Ma-Pe-Ma/Shutter-Controller/(list of files, drawings)

Other design files:
Controlling Circuit/ShutterController/PCB_ShutterController.json
