Ma-Pe-Ma/Shutter-Controller/Wasm-client/src/sc/RequestQueue.h

#ifndef REQUESTQUEUE_H
#define REQUESTQUEUE_H

#include <queue>
#include <memory>
#include <mutex>
#include <atomic>

#include "request/Request.h"

class RequestQueue {
	std::queue<std::shared_ptr<Request>> requestQueue;
	std::shared_ptr<Request> currentRequest = nullptr;
	std::mutex requestMutex;

	std::string siteAddress = "";
	std::string parameters = "";

	bool lastRequestSuccess = true;
public:
	void setSiteAddress(std::string siteAddress, std::string parameters) {
		this->siteAddress = siteAddress;
		this->parameters = parameters;
	}

	void pushNewRequest(std::shared_ptr<Request> newRequest);
	void pushNewRequestIfQueueIsEmpty(std::shared_ptr<Request> newRequest);	

	bool isActive();
	bool getLastRequestSuccess() { return lastRequestSuccess; }	

	void tryDequeue();
	void terminate();
};

#endif // !REQUESTQUEUE_H
