Ma-Pe-Ma/Shutter-Controller/ESP8266_Server/src/app/Processes/ZeroProcess.cpp

#include "ZeroProcess.h"
#include "../TimeCalibration.h"

void ZeroProcess::start(const float currentValue) {
    processStartTime = millis();
    digitalWrite(UP_PIN, DEACTIVATE_PIN);
    digitalWrite(DOWN_PIN, DEACTIVATE_PIN);

    zeroFound = false;
    targetValue = currentValue;

    if (targetValue < 0.5f) {
        processTime = 1.0f / downSpeed;
        digitalWrite(DOWN_PIN, ACTIVATE_PIN);
    }
    else {
        processTime = 1.0f / upSpeed;
        digitalWrite(UP_PIN, ACTIVATE_PIN);
    }

    processTime += 3.0f;

    Serial.println("Zero process started, process time: " + String(processTime));
}
    
bool ZeroProcess::checkFinished() {
    if (!zeroFound) {
        if (millis() - processStartTime > processTime * 1000) {   
            if (targetValue < 0.5f) {
                digitalWrite(DOWN_PIN, DEACTIVATE_PIN);
                digitalWrite(UP_PIN, ACTIVATE_PIN);
                processTime = targetValue / upSpeed;
            }
            else {
                digitalWrite(UP_PIN, DEACTIVATE_PIN);
                digitalWrite(DOWN_PIN, ACTIVATE_PIN);                
                processTime = (1.0f - targetValue) / downSpeed;
            }

            zeroFound = true;
            processStartTime = millis(); 

            Serial.println("Zeroing half, new processs time: " + String(processTime));
        }
    }
    else {
        if (millis() - processStartTime > processTime * 1000) {
            digitalWrite(UP_PIN, DEACTIVATE_PIN);
            digitalWrite(DOWN_PIN, DEACTIVATE_PIN);
            
            Serial.println("Zeroing finished: " + String(targetValue));
            return true;
        }
    }

    return false;
}

std::tuple<Shutter_Event, int> ZeroProcess::generateMessage() {
    return {Shutter_Event_zero_find, (int) (targetValue * 100)};
}
