Ma-Pe-Ma/Shutter-Controller/ESP8266_Server/src/app/MessageHandler.cpp

#include "MessageHandler.h"
#include "TimeCalibration.h"

#include "pb_decode.h"
#include "pb_encode.h"

void MessageHandler::initialize() {
    loadMessagesFromFlash();
    //TODO: add proper value for start
    addNewMessage(Shutter_Event_start, 0);
}

void MessageHandler::addNewMessage(Shutter_Event event, int value) {
    for (int i = 0; i < NR_OF_MESSAGES - 1; i++) {
        messageContainer.genericMessage[NR_OF_MESSAGES - 1 - i] = messageContainer.genericMessage[NR_OF_MESSAGES - 1 - i - 1];
    }

    Shutter_GenericMessage genericMessage = Shutter_GenericMessage_init_default;
    genericMessage.event = event;
    genericMessage.value = value;
    
    String dateString = TimeCalibration::getFormattedString();
    strncpy(genericMessage.datetime, dateString.c_str(), dateString.length());

    messageContainer.genericMessage[0] = genericMessage;

    saveMessagesToFlash();
}

void MessageHandler::saveMessagesToFlash() {
    uint8_t buffer[Shutter_MessageContainer_size];
    pb_ostream_t stream = pb_ostream_from_buffer(buffer, Shutter_MessageContainer_size);
    
    if (!pb_encode(&stream, Shutter_MessageContainer_fields, &messageContainer)) {
        Serial.println("Failed to encode messageContainer...");        
    }
    else {
        LittleFSHandler::writeFile("messages.txt", buffer, stream.bytes_written);
    }
}

void MessageHandler::loadMessagesFromFlash() {
    messageContainer.genericMessage_count = NR_OF_MESSAGES;

    String messagesDump;
    LittleFSHandler::readFile("messages.txt", messagesDump);    

    bool initContainer = true;

    if (messagesDump != "") {
        pb_istream_t istream = pb_istream_from_buffer((const unsigned char*) messagesDump.c_str(), messagesDump.length());
        if (pb_decode(&istream, Shutter_MessageContainer_fields, &messageContainer)) {
            initContainer = false;
        }
        else {
            LittleFSHandler::deleteFile("messages.txt");
        }
    }

    if (initContainer) {
        for (int i = 0; i < NR_OF_MESSAGES; i++) {
            messageContainer.genericMessage[i].event = Shutter_Event_empty;
            messageContainer.genericMessage[i].value = 0;
            strncpy(messageContainer.genericMessage[i].datetime, "-", 1);
        }
    }

    String dateString = TimeCalibration::getFormattedString();
    strncpy(messageContainer.startTime, dateString.c_str(), dateString.length());    
}
