Ma-Pe-Ma/Shutter-Controller/(commit log)

2020-09-29 Reworked timing de/serialization + started working on HTTP requests
2021-10-23 Ultramega server update (restructuring + many oth)
    [Configuration.h]
2021-10-24 Minor button width fix on Desktop Client + images
2021-11-01 Fixing json memory problem
    [MessageHandler.cpp, MessageHandler.h]
2021-11-01 Desktop: images + timeout fix + new button
2022-01-06 New macros + minor fixes
    [Configuration.h]
2022-03-06 Development started on simple browser client
    [Configuration.h]
2022-05-28 Adding circuit/pcb + expanding ReadMe with it
    [PCB_ShutterController.json]
2022-07-23 Adding browser client + memory leak fixes
    [Configuration.h]
2022-07-26 Expanding ReadMes + minor fixes
    [BrowserClient.h, ServerContainer.cpp]
2022-08-17 Update ReadMe.md - Adding PCB photos
2023-08-14 Restructuring HTML+JS client + update ReadMe-s
    [Configuration.h]
2023-11-05 Minor fixes
    [Configuration.h]
2023-12-29 Redesigning frontend with Bootstrap
    [BrowserClient.h, DemoRequest.h, MainWindow.cpp, ServerContainer.cpp, SettingProcess.cpp, Timing.h]
2024-03-31 Transforming server code into PlatformIO project
    [Configuration.h]
2024-04-21 New configuring procedure for server
    [Configuration.h]
